ska-sa/astt-2024/software/README.md

# ASTT Software

The software subsystem contains the Angular frontend, FastAPI backend, SQLite
database layer, Docker Compose setup, and design diagrams.

## Structure

```text
software/
├── backend/
├── frontend/
├── design/
└── docker-compose.yaml
```

## Run with Docker

From the repository root:

```bash
cp software/.env.example software/.env
# Set HOST_IP in software/.env to this computer's LAN IP.
docker compose -f software/docker-compose.yaml up --build
```

The frontend is served on `http://<HOST_IP>:4200` and the API on
`http://<HOST_IP>:8000`. The frontend automatically rebuilds and refreshes when
files under `software/frontend` change. Rebuild the container when dependencies
in `package.json` change. Docker stores SQLite data in the persistent
`backend-databases` volume.

The backend source is copied into its image; it is not mounted from the host.
After backend changes, rebuild/recreate that service so the running API uses
the new model and migration:

```bash
docker compose -f software/docker-compose.yaml up -d --build astt-software-backend-service
```

The `serial_log` migration adds a nullable SQLite column without replacing old
records. Keep the named database volume during updates; do not use `down -v`.

On 2026-10-22, another project's auto-scheduler occupied ports `8000`/`4200`,
and requests reached that application instead of ASTT. With user approval, only
that project's frontend/backend containers were stopped and ASTT was rebuilt/
started on its existing ports. Mongo services and volumes were retained; no
Compose, environment, or port changes were needed. If this recurs, inspect which
containers own the ports before changing configuration or stopping anything.
After the approved switch, the frontend and existing reading/command routes
returned HTTP 200 with the persistent database retained. Old rows correctly
return `serial_log: null`; new diagnostic lines require updated firmware readings.

## Track command repair — 2026-11-04

Command history permits repeated source names; the source catalogue still keeps
names unique. Migration retains command IDs/history, and POST returns the newly
inserted ID. This fixes repeated Track requests returning an old command or
raising IndexError after a failed insert. Rebuild the backend to apply it.

The separate **Fast sky sweep (1 min, 2026)** source uses the existing fields;
original **Sun** is unchanged. The revised parameters repeat every minute
while staying above the local horizon: AZ about −62° to −35°, EL 33° to 57°.
Refresh CAM and submit a new Track command to use revised source parameters.
The previous two-axis Track firmware is required for EL tracking. See [Track checks](../agents/work/056-continuous-tracking/completion.md).

## Current API flow

- Hardware posts telemetry to `POST /api/v1/readings`.
- The CAM page reads `GET /api/v1/readings/{telescope_id}/latest`.
- The frontend posts nested Point or Track commands to `POST /api/v1/commands`.
- Hardware polls `GET /api/v1/commands/{telescope_id}/latest`.
- Updated firmware GETs/PUTs its existing telescope record asynchronously to publish AZ
  limits in JSON `metadata`. CAM loads the same metadata and rejects invalid
  Point targets with an inline error; the backend validates configured limits too.

ASTT-085 established encoder-only Point tests with a zero offset. Its raw AZ
range runs from `137.8°` through `360°/0°` to the assumed `37.8°` opposite stop.
In that encoder-only frame, `250°`, `350°`, and `20°` are allowed and `100°` is
rejected. The user confirmed tests at `20°`, `30°`, and `200°` without
limit-switch strikes. The operator now confirms both stops and clockwise 1:1
encoder mapping. These
raw test angles must be shifted by the recorded offset for referenced Point
commands; the UI displays the resulting signed AZ angle.

ASTT-043 uses `USE_MANUAL_AZ_REFERENCE = true` with recorded
`encoderAtNorth = 267.8°`, the midpoint along the verified 260° raw arc.
The fixed offset is `92.2°`; AZ is `norm360(raw encoder + offset)`.
The operator manually levels and north-aligns the base at that midpoint before
sending a fresh command. There are no new alignment/calibration buttons, login
requirements or Serial interaction commands. Firmware cannot verify alignment
or detect later base repositioning: stop, realign and send a new command after
moving the base. No startup movement or old-command replay occurs.

Compass initialization/retry and continuous field reads are reused from the
working standalone sketch on the same shared I2C bus. Magnetic readings remain
visible in the app, Serial and Show more but never change the manual reference.
Full magnetic calibration/automatic referencing stays deferred under ASTT-047.

Declination is calculated on the MCU for `2026 <= decimal UTC year < 2028`;
invalid/unsupported dates return `NAN` rather than a fallback. This affects
diagnostic true heading, not manual Point. Celestial Track keeps its real-UTC
requirement. Firmware enforces encoder availability. Existing telescope metadata
publication is best effort, not permission for local motor movement. CAM
refreshes numeric limits/offset on new readings and before commands without
starting motion. Old readiness/calibration flags do not block Point. Alignment
metadata stays internal; frontend/backend keep the numeric raw-arc checks. True `0°/360°`
is rejected if subtracting the offset places it inside the blocked raw arc.

### CAM reading views

The sensor panel opens in **Simple**: a signed AZ gauge (0° up, −130° to +130°),
an EL arc (−15° to +92°, 0° right, positive angles upward), and GPS below. Larger measured
values follow the arrow tips just outside each arc, on white backgrounds. **Raw** shows all existing sensor fields and Show more diagnostics.
Both views use the same live reading; switching never sends a command. Both
gauges use solid triangular pointers.

The AZ gauge shows allowed travel in gray and unused travel in white, using
the current encoder endpoints plus the published offset. The arc stays fixed when only AZ moves. Readings already
contain their reference offset and are not shifted again. EL travel limits are
not yet available: its arc is a temporary display scale, not a measured travel range.
Actual EL readings remain visible without clamping.
Missing feedback shows Not available. Reference and hardware qualification remain
separate from ASTT-097/098's UI work.

### UI Point angles (ASTT-099)

Manual Point accepts **AZ −130° to +130°** and **EL −15° to +92°**, as requested
for operator reference tests (ASTT-042/044, 2026-11-03). Only the UI changes
representation: −90° on either axis sends API 270°, and API 275° displays −85°.
CAM Simple/Raw views, its history chart, the Readings table and command history
all show signed angles. Existing encoder limits/offsets, API angles and firmware
remain unchanged; readings already include the reference offset.

Targets start at `(0, 0)` and initialize once from valid, in-range readings on
the initial load. A failed initial load leaves those defaults. Edits made before
that response, later polling and Point/Track switching never overwrite targets.
Actual telemetry is never clamped to the input range. Hold still sends the exact
latest API angles. Reference/offset and software-hold helper paragraphs are
removed from the UI; serial diagnostics remain verbatim in Show more.

### Remote reading diagnostics

The firmware sends `elevation_angle = norm360(el_encoder_angle + EL_ENCODER_OFFSET)`.
The operator-confirmed offset is +70.37° (`-19.63 + 90`): raw encoder 19.63°
displays 90°, and a zero-degree target maps to raw 289.63°.
Firmware applies this once; the UI only converts wrapped degrees to signed
values. The requested UI range is not yet confirmed physical travel: earlier
historical upper raw 65.93° now reads 136.3°, so scale/stop validation remains pending.
Raw `el_encoder_angle: number | null` remains available for feedback diagnostics and recording stops. The nullable
column migration preserves existing records and every reading route includes it.
For the first reading-only firmware, a valid `elEnc=... EL_ENC=OK` log supplies
missing encoder data. Its `EL_MPU=` marker identifies the older zero-offset frame,
so the API exposes that encoder value as elevation too. New firmware's referenced
`elevation_angle` is preserved, without applying an offset again.

CAM's Position panel, history diagnostics, graph and Readings table consistently
show **Elevation Angle**, matching **Azimuth Angle**. Zero is a real reading;
missing encoder feedback shows Not available/a graph gap. The Readings table
refreshes every five seconds and CAM recovers after transient poll failures.
Reading refreshes never submit motion commands. The history graph retains its
Load graph/date/sampling controls. Magnetic fields remain Tesla in the API.

The API/firmware still accept EL angles from 0 to 360 degrees for encoder tests;
the manual UI Point form accepts signed EL −15° to +92°. Neither
is a measured travel range. EL Point uses PWM 128–255 with the existing 30°
ramp and trial 0.05° tolerance. The current trial adds short near-target corrections,
settling before reversal and continued encoder-based hold after arrival.
Lost/stale feedback, E-stop or ten seconds without command communication cancel
movement. Physical switches cut motor power while stops are being measured.
EL Track now follows the source through the same encoder controller. Both axes
pause for out-of-range Track targets; physical EL stop calibration remains open. The hold button
uses the latest referenced elevation and requires valid encoder feedback.

Rebuild/recreate only ASTT's backend to load compatibility changes, preserving
its database volume. The development frontend reloads mounted source. The operator
approved the backend restart on 2026-10-30; the initial reading/UI changes were
committed and pushed as `4da6e3c`. The new EL movement/reference patch is also
operator-accepted in both directions and approved for commit/push on 2026-10-30.

Each reading may contain `serial_log: string | null` through existing reading
POST/PUT, latest, list, and range routes. The field is optional and limited to
2048 characters; old payloads and rows return null. Firmware creates a bounded
1024-byte snapshot, prints it roughly once per second, and posts it every five
seconds alongside the sensor values. CAM's live panel, sampled history, and the
readings list expose escaped text under **Show more**; it is never rendered as HTML.

The line records angles, targets, requested PWM, sensor availability and values,
command events, site source, and previous HTTP results. Manual health is FAULT for
E-stop, missing AZ encoder feedback or network-worker failure; DEGRADED for
missing magnetic/date diagnostics, MPU, EL encoder or GPS fix,
and otherwise OK; none of these states qualifies heading accuracy. E-stop
continues posting readings/logs with motor outputs off and command polling paused.

The firmware posts encoder-derived manual `azimuth_angle`, so live readings and history
display it directly, without adding the current offset again. Old readings
retain the reference they used at the time. Magnetic fields remain Tesla in the
API and are displayed as `µT`.
Encoder feedback controls motor error/stopping and mechanical limits. The manual
offset stays fixed between commands as well as during them. Invalid compass
samples mark diagnostic heading stale, without replacing AZ or blocking manual Point.

The Telescopes/device table polls each device's existing latest-reading route
with overlap guards and stops polling when the page is destroyed. It shows that
reading's health and **Last seen**, not the telescope record's initial OK value.
Missing, failed, future or older-than-10-second readings gray out the row; no
Online/Offline label is added. These read-only updates never issue commands.

HTTP now runs in an ESP32 worker with copied snapshots so its 2 s/5 s requests
do not intentionally interrupt motor PWM. Command IDs, E-stop, encoder limits
and the 10 s communication timeout remain authoritative; stale replies cannot
resume cancelled commands. AZ uses PWM 150–255 and EL 128–255. AZ holds its
current Point target with trial 0.05° tolerance and short corrections near arrival;
EL now trials the same correction/settling approach with trial 0.05°
tolerance. The operator accepts this version; independent accuracy and
limit/E-stop qualification remain open.
CAM rounds AZ/EL Point fields to at most two decimal places on initialization,
leaving the field, and submission. A hold command preserves the exact latest
reading in its payload; only its displayed input values are rounded. Live and
historical telemetry are not rounded or overwritten by this input formatting.
After flashing/rebooting, manually prepare alignment, then submit a new command:
the firmware deliberately ignores commands saved before startup. The existing
UI popup confirms command submission, not arrival. Firmware `AZ POINT COMPLETE`
latches the AZ stop only; repeated command IDs cannot restart it after base
movement. A new command is required after completion, communication timeout, or
E-stop. EL Point also latches completion, with physical stopping still unqualified.
`ON TARGET` requires valid AZ/EL feedback and both completion latches; the extra
arrival popup remains deferred.

### Software hold (ASTT-084)

The red **Stop / hold position** button beside Point and Track fetches the latest
reading and posts a Point command with those reported AZ/EL values unchanged.
It needs a signed-in user, numeric AZ limits/offset, and fresh online readings within
the allowed range. Invalid/faulted readings and overlapping submissions are
rejected; pending hold requests are cancelled when leaving CAM.

This is not an emergency stop or motor-power cut. Telemetry and command polling
introduce delay, and the telescope may move back toward an older reported
position. The popup confirms submission only. Use the physical E-stop for
emergencies; its qualification remains ASTT-051. No new API endpoint is added.

## Software work items

| ID | Status | Detail |
|---|---|---|
| ASTT-001 | Done | SQLite creates the telescope, reading, command, source, and user tables. Legacy command and source schemas migrate on startup. |
| ASTT-002 | Done | FastAPI exposes CRUD operations for the main entities. |
| ASTT-003 | Done | Hardware can retrieve the latest command for one telescope. |
| ASTT-004 | Done | Readings can be queried for a telescope and date range. |
| ASTT-005 | Done | Commands use `point` or `track` payloads matching the backend models. |
| ASTT-006 | Done | The CAM controls can submit Point and Track commands. |
| ASTT-007 | Done | The CAM page polls and displays the latest sensor reading. |
| ASTT-008 | Done | Users can create, update, select, and delete tracking sources. |
| ASTT-009 | Done | Command history displays Point angles or a Track source. |
| ASTT-010 | Done | Plot measured azimuth and elevation with date filtering and selectable sampling. |
| ASTT-011 | Todo | Add Keycloak only after the physical Point/Track loop is stable. |
| ASTT-081 | Done | Show a blue command confirmation and keep the navbar visible while scrolling. |
| ASTT-084 | Done | Red software hold button sends latest measured AZ/EL as a Point command; mocked frontend checks pass, physical behaviour still needs operator verification. |
| ASTT-085 | Point tests passed; final calibration pending | Encoder-only AZ reference, shared JSON limits, and Point range validation. |
| ASTT-043 | Manual reference implemented; independent accuracy pending | Fixed midpoint north, unchanged raw limits, encoder-derived AZ and separate magnetic diagnostics; no new controls. |
| ASTT-092 | Software verified | Optional reading diagnostics, preserved legacy rows, actual sensor health, and escaped Show more in reading views. |
| ASTT-093 | Software verified; powered checks pending | HTTP worker keeps feedback active during requests, motor PWM no longer pauses for HTTP, and device rows use latest-reading health/freshness. |
| ASTT-099 | Software verified | Signed AZ/EL display/input (EL −15° to +92° for ASTT-042/044), one-time initial targets and minimal control-panel text; API/firmware unchanged. |

ASTT-055 basic encoder-feedback EL Point movement is complete per operator
confirmation in both directions. Measured limits, zero and full qualification
remain open; ASTT-096 tracks replacement of the slow EL motor.

## Software verification

```bash
cd software/frontend
npm ci --legacy-peer-deps
npm run build -- --configuration production --no-progress
```

```bash
docker compose -f software/docker-compose.yaml config
```
