ska-sa/astt-2024/agents/work/036-permanent-mounting-enclosure/prompt.md

# ASTT-036: Rear electronics enclosure

**Status:** IN PROGRESS — design/assembly with teammates; not qualified
**Area:** Hardware | Mechanical
**Priority:** HIGH — parallel to the encoder-motion milestone

## Context and goal

Make the electronics enclosure at the back of the assembly. This is mechanical
work, not a prerequisite for automatic magnetic referencing.

## In scope

- Confirm board/driver/power dimensions and rear mounting points with teammates.
- Provide secure mounting, access to connectors/E-stop, ventilation as needed,
  cable strain relief and clearance across the measured AZ/EL travel.
- Coordinate printing/assembly under ASTT-038 and cable checks under ASTT-039.

## Out of scope

New wiring/pins, altered travel limits, or declaring protection/accuracy verified
from a CAD model alone. No powered movement is authorised by this ticket.

## Decisions and questions

User confirms rear electronics enclosure work is ongoing. Confirm dimensions,
materials, team responsibilities and service access before final manufacture.

## Acceptance criteria

- [ ] Reviewed design fits the actual electronics and rear attachment points.
- [ ] Assembled enclosure is secure and accessible, with cables protected.
- [ ] Supervised clearance checks cover the permitted movement without strain.

## Likely files and verification

Agreed enclosure CAD/print files and hardware assembly notes. Inspect the fit
unpowered first, then perform operator-approved movement/clearance checks.
