ska-sa/astt-2024/agents/work/077-system-presentation-script/prompt.md

# ASTT-077: Whole-system presentation script

**Status:** TODO — after motion tests and necessary calibration
**Area:** Documentation | Delivery
**Priority:** CRITICAL

## Goal and scope

Prepare one concise script covering the complete system and what was actually
demonstrated. Coordinate ASTT-076 presentation and ASTT-079 rehearsal/fallback.

- Cover purpose, mechanics, electronics, encoders/limits/E-stop, firmware,
  API/database, UI, command flow and measured telemetry.
- Explain recorded midpoint zeros/signed angles separately from manual true-north
  alignment/levelling and any future automatic sensor references.
- Show tested AZ/EL Point and return to (0, 0); include fixtures, three-point
  method, measured errors/repeatability, limitations and remaining work.
- Assign speakers/transitions/timing. Confirm whether the previous 15-minute
  presentation/five-minute demo plan still applies; prepare a safe fallback.

## Out of scope

Claims of finished EL, calibrated absolute accuracy or reliable celestial Track
without evidence. No slide deck is created by logging this ticket; fitting is later.

## Acceptance criteria and verification

- [ ] Script matches the working system, test evidence and known limitations.
- [ ] Roles/timing and safe reproducible demo/fallback are agreed.
- [ ] Team rehearses under ASTT-079 and incorporates factual corrections.

Likely files: agreed script/deck location and test-evidence links. Review against
recorded results, then rehearse after the physical milestone is demonstrated.
