ska-sa/astt-2024/agents/templates/prompt.md

# ASTT-NNN: Short title

**Status:** Draft
**Area:** Software | Hardware | Integration | Documentation

## Context

Briefly describe the current system and why this work is needed.

## Goal

State one concrete outcome.

## In scope

- Required change

## Out of scope

- Work intentionally deferred

## Decisions and questions

- Record confirmed decisions.
- List unresolved questions before implementation.

## Acceptance criteria

- [ ] Observable result that proves the work is complete
- [ ] Relevant tests or manual checks pass
- [ ] Documentation and the root checklist are updated

## Likely files

- `path/to/file`

## Verification

- Command, measurement, or manual test to run
