ska-sa/astt-2024/agents/work/088-compressed-sun-tracking/completion.md

# ASTT-088 work record

**Status:** Logged 2026-10-19 — implementation not started

The short solar replay and paired-error dataset request is captured in
`prompt.md`. Compression of a day's selected path is a draft assumption.
No trajectory generated, real clock changed, commands posted, or motor moved.

## 2026-11-04 — separate fast motion pattern

Under ASTT-056 the operator chose a separate synthetic 30-minute daily pattern
using existing source fields. It is added alongside the unchanged Sun. A true
dated solar replay and paired target/measurement error records are still pending;
this does not complete ASTT-088. See ../056-continuous-tracking/completion.md.
