ska-sa/astt-2024/agents/work/087-device-viewer-access/completion.md

# ASTT-087 work record

**Status:** Logged 2026-10-19 — implementation not started

Owner-managed read-only sharing is captured in `prompt.md` and depends on
verified sessions. No ownership, permissions, device records, or runtime
access behavior changed in this turn.
