ska-sa/astt-2024/agents/work/089-base-level-indicator/completion.md

# ASTT-089 work record

**Status:** Logged 2026-10-19 — implementation not started

The manual-level indicator request is captured in `prompt.md`, reusing the base
MPU if suitable. Axes and tolerance remain to confirm. No extra sensor, wiring,
motion interlock, or runtime display was added in this turn.
