ska-sa/astt-2024/agents/work/081-command-message-navbar/completion.md

# ASTT-081 completion

**Status:** Complete

## Result

- Changed command success feedback to a blue Bootstrap-style message.
- Kept the existing three-second automatic dismissal.
- Made the navbar remain at the top while scrolling.
- Positioned the message below the navbar.
- Added a Docker development stage with Angular file watching.

## Verification

- Angular production build passed.
- Git whitespace checks passed.
- Point and Track continue to use the existing success callbacks.
- Docker Compose configuration passed.
- Touching a frontend source file triggered a development rebuild in 0.552 seconds.
- The production Docker target built successfully.
