ska-sa/astt-2024/agents/work/010-monitoring-graph/completion.md

# ASTT-010 completion

**Status:** Complete

## Result

- Added a historical graph for measured azimuth and elevation angles.
- Defaulted the date range to today.
- Added selectable sampling from every reading to hourly.
- Reused the existing reading-range endpoint without backend changes.
- Placed the History Panel below the Control Panel and load it on page open.
- Added a grey offline state and last-active time for stale sensor readings.

## Verification

- Angular production build passed.
- Git whitespace checks passed.

## Deferred

- Target-versus-actual comparison can be added when target history is available.
