ska-sa/astt-2024/agents/work/080-combine-repositories/completion.md

# ASTT-080 completion

**Status:** Complete

## Result

- Combined tracked hardware and software files under one repository.
- Added shared project context, work-item tracking, and agent instructions.

## Verification

- Angular production build passed from `software/frontend`.
- Docker Compose configuration passed from the repository root.
- Core backend modules passed Python byte-compilation.
- Hardware credential scan passed; copied firmware now uses placeholders.
- Firmware compilation was not run because Arduino CLI and PlatformIO are unavailable.
- The existing `software/backend/tests/test_database.py` still has an indentation
  error that was already present on `origin/master`.
