ska-sa/astt-2024/(commit log)

2026-09-25 Add elevation feedback and motor control
2026-09-25 Reference azimuth encoder to true north
2026-09-25 Add magnetometer qualification procedure
2026-09-25 Plan motor control calibration
2026-09-25 Make E-stop handling fail-safe
    [wemos_lilon32.ino]
2026-09-25 Add motor calibration procedure
2026-10-02 Fix sensor online status timestamp
2026-10-16 Fix encoder-only pointing and shared azimuth limits
2026-10-30 Expose EL encoder readings with a minimal UI
2026-10-30 Drive elevation Point targets with encoder feedback
2026-11-02 Tighten EL stopping tolerance at full PWM
2026-11-05 Buffer encoder feedback and add bounded motor assistance
2026-11-05 Set 0.05-degree tolerances and direct maximum motor assistance
2026-11-05 Plan bounded reverse-and-retry motor recovery
2026-11-06 Simplify location labels and style Sign Out button
